dgraselli/tanteador-universal/pruebas.py

# pruebas.py
# Página web de pruebas del tablero, pensada para el celular: conectado a la
# red TNT, abrís http://192.168.216.1 y tenés un botón por prueba, para
# disparo con una mano mientras mirás el monitor con la otra.
#
# Cada prueba aísla un sospechoso del parpadeo del monitor:
#   - Silencio: abre el stream de audio HDMI sin sonido. Si el monitor
#     parpadea con esto, el enlace HDMI se cae solo por arrancar el audio.
#   - Beep: el mismo beep de un punto, pero sin tocar el tanteador.
#   - Chicharra: pulso en el GPIO, sin audio. Prueba el ruido eléctrico
#     del módulo MOSFET/relé por separado.

import fcntl
import io
import json
import math
import os
import struct
import subprocess
import sys
import threading
import time
import wave
from http.server import BaseHTTPRequestHandler, ThreadingHTTPServer

import historial
from registro import Registro, ruta_registro, ultimo_ts

PORT = int(sys.argv[1]) if len(sys.argv) > 1 else 80

REGISTRO = Registro('pruebas')

# Mismo pin y misma síntesis que tanteador.py (duplicado a propósito: importar
# tanteador acá cargaría PyQt entero en un segundo proceso, y la Zero no sobra
# memoria).
CHICHARRA_GPIO = 18
SAMPLE_RATE = 44100

def _wav_beep(pulsos, freq):
    """WAV mono de 16 bits con los pulsos (duración, silencio) en segundos.
    Con freq=0 el seno es siempre cero: sale un WAV de silencio, que igual
    abre el stream de audio HDMI, que es lo que la prueba necesita."""
    frames = bytearray()
    rampa = int(SAMPLE_RATE * 0.005)
    for dur, silencio in pulsos:
        n = int(SAMPLE_RATE * dur)
        for i in range(n):
            amp = 32000
            if i < rampa:
                amp = amp * i // rampa
            elif i > n - rampa:
                amp = amp * (n - i) // rampa
            frames += struct.pack('<h', int(amp * math.sin(2 * math.pi * freq * i / SAMPLE_RATE)))
        frames += b'\x00\x00' * int(SAMPLE_RATE * silencio)
    buf = io.BytesIO()
    with wave.open(buf, 'wb') as w:
        w.setnchannels(1)
        w.setsampwidth(2)
        w.setframerate(SAMPLE_RATE)
        w.writeframes(bytes(frames))
    return buf.getvalue()

WAVS = {
    'silencio': _wav_beep([(1.0, 0)], 0),
    'beep': _wav_beep([(0.30, 0)], 1000),   # igual al beep de anotar
}

# Una prueba a la vez: un doble toque en el celular no encima dos aplay.
_lock = threading.Lock()

def _aplay(nombre):
    # Con el daemon de audio corriendo (silencio.service), el sonido sale por
    # su FIFO: el canal HDMI ya está abierto y además el dispositivo es suyo
    # (un aplay directo daría "device busy").
    try:
        fd = os.open('/run/tnt/beeps', os.O_WRONLY | os.O_NONBLOCK)
        try:
            os.write(fd, f'{nombre}\n'.encode())
        finally:
            os.close(fd)
        return 'enviado al daemon de audio (canal HDMI siempre abierto)'
    except OSError:
        pass  # el daemon no está: aplay directo
    p = subprocess.run(['aplay', '-q'], input=WAVS[nombre],
                       stdout=subprocess.DEVNULL, stderr=subprocess.PIPE,
                       timeout=10)
    if p.returncode != 0:
        err = p.stderr.decode(errors='replace').strip()
        # 524 (ENOTSUPP): el driver vc4-hdmi no ofrece audio porque el monitor
        # no declaró soportarlo. Con un EDID que llega corrupto, pasa aunque el
        # monitor sí tenga audio: es un síntoma más del enlace HDMI fallado.
        if 'error 524' in err:
            raise RuntimeError('el HDMI quedó SIN AUDIO en este arranque: el '
                               'driver no le leyó soporte de audio al monitor '
                               '(EDID corrupto). Los beeps del tanteador '
                               'tampoco están sonando. Dato importante: '
                               'anotalo junto con la hora.')
        raise RuntimeError(err or 'aplay falló')
    return 'sonó por el parlante (HDMI)'

def _chicharra():
    import time
    import RPi.GPIO as GPIO
    GPIO.setmode(GPIO.BCM)
    GPIO.setwarnings(False)
    GPIO.setup(CHICHARRA_GPIO, GPIO.OUT, initial=GPIO.LOW)
    GPIO.output(CHICHARRA_GPIO, GPIO.HIGH)
    time.sleep(0.3)
    GPIO.output(CHICHARRA_GPIO, GPIO.LOW)
    # Sin GPIO.cleanup(): dejaría el pin como entrada y el tanteador, que ya
    # lo configuró como salida en su propio proceso, escribiría al vacío.
    return f'pulso de 0.3 s en GPIO{CHICHARRA_GPIO}'

PRUEBAS = {
    '/silencio': lambda: _aplay('silencio'),
    '/beep': lambda: _aplay('beep'),
    '/chicharra': _chicharra,
}

# ── Señal del control remoto ─────────────────────────────────────────────
# La versión para celular de medir-senal.sh: el control publica su RSSI por
# MQTT cada 5 segundos, y acá se muestra en vivo mientras caminás la cancha.
# Los puntos de medición se marcan con un botón de la página, no con el botón
# del LOCAL: así medir no suma tantos en el tablero.

UMBRALES = [(-60, 'excelente'), (-70, 'bien'),
            (-80, 'MARGINAL: se corta a ratos'), (-999, 'SIN ENLACE ÚTIL')]

def _calidad(dbm):
    for limite, texto in UMBRALES:
        if dbm >= limite:
            return texto

class Senal:
    """Escucha los 'rssi' del control por MQTT y lleva los tramos medidos."""

    def __init__(self):
        self.lock = threading.Lock()
        # (monotonic, dbm) de la última muestra. Monotonic y no time.time():
        # la hora de pared salta cuando un celular pone la Pi en hora.
        self.ultimo = None
        self.minuto = []        # muestras desde la última anotación de salud
        self.tramos = []        # una lista de dbm por cada punto marcado
        self.error = None
        try:
            import paho.mqtt.client as mqtt
            cliente = mqtt.Client()
            cliente.on_connect = lambda c, u, f, rc: c.subscribe('rssi')
            cliente.on_message = self._mensaje
            # connect_async + loop_start: reintenta solo si mosquitto no está.
            cliente.connect_async('localhost', 1883, 60)
            cliente.loop_start()
        except Exception as e:
            self.error = f'sin MQTT: {e}'

    def _mensaje(self, cliente, userdata, msg):
        try:
            dbm = int(msg.payload)
        except ValueError:
            return
        with self.lock:
            self.ultimo = (time.monotonic(), dbm)
            self.minuto.append(dbm)
            # Con 500 muestras (~40 min) alcanza para cualquier medición; el
            # tope evita crecer para siempre si alguien deja un punto abierto.
            if self.tramos and len(self.tramos[-1]) < 500:
                self.tramos[-1].append(dbm)

    def tomar_minuto(self):
        """Las muestras juntadas desde la última llamada (y las descarta)."""
        with self.lock:
            muestras, self.minuto = self.minuto, []
            return muestras

    def punto(self):
        with self.lock:
            self.tramos.append([])
            return f'punto {len(self.tramos)} marcado: quedate quieto ~20 s'

    def reset(self):
        with self.lock:
            self.tramos = []
            return 'medición reiniciada'

    def estado(self):
        with self.lock:
            r = {'error': self.error, 'ahora': None, 'tramos': []}
            if self.ultimo:
                ts, dbm = self.ultimo
                r['ahora'] = {'dbm': dbm, 'edad': round(time.monotonic() - ts),
                              'calidad': _calidad(dbm)}
            for t in self.tramos:
                if t:
                    peor = min(t)
                    r['tramos'].append({'muestras': len(t), 'peor': peor,
                                        'mejor': max(t),
                                        'media': round(sum(t) / len(t)),
                                        'calidad': _calidad(peor)})
                else:
                    r['tramos'].append({'muestras': 0})
            return r

SENAL = Senal()

# ── Bitácora: salud del tablero y reloj ──────────────────────────────────
# Lo que anota el tanteador (puntos, demoras, trabones) se completa acá con
# lo que él no ve: la señal del control, la memoria, la temperatura y la
# tensión de la fuente. historial.py lo junta todo en /historial.

# Sin noticias del control por más de esto, se anota un corte.
CORTE_CONTROL_SEG = 15

def _leer(ruta):
    with open(ruta) as f:
        return f.read()

def _salud():
    """Una foto de la Pi y del control, para la bitácora."""
    datos = {}
    try:
        mem = dict(l.split(':', 1) for l in _leer('/proc/meminfo').splitlines())
        datos['mem'] = int(mem['MemAvailable'].split()[0]) // 1024
    except (OSError, KeyError, ValueError):
        pass
    try:
        st = os.statvfs('/media/root-rw')  # lo escrito en la RAM del overlay
        datos['ram_rw'] = (st.f_blocks - st.f_bfree) * st.f_frsize // 1024
    except OSError:
        pass
    try:
        datos['carga'] = float(_leer('/proc/loadavg').split()[0])
        datos['temp'] = round(int(_leer('/sys/class/thermal/thermal_zone0/temp')) / 1000, 1)
    except (OSError, ValueError):
        pass
    try:
        # Bits de tensión baja y de baja de velocidad (actuales e históricos).
        salida = subprocess.run(['vcgencmd', 'get_throttled'], capture_output=True,
                                text=True, timeout=5).stdout
        datos['thr'] = int(salida.strip().split('=')[1], 16)
    except (OSError, IndexError, ValueError, subprocess.SubprocessError):
        pass
    muestras = SENAL.tomar_minuto()
    datos['rssi_n'] = len(muestras)   # deberían ser ~12 por minuto
    if muestras:
        datos['rssi_min'] = min(muestras)
    return datos

def _vigilar():
    """Anota la salud cada minuto y los cortes del control en cuanto pasan."""
    perdido_desde = None
    proxima_salud = time.monotonic() + 60
    while True:
        time.sleep(2)
        ahora = time.monotonic()
        with SENAL.lock:
            ultimo = SENAL.ultimo
        if ultimo:
            hace = ahora - ultimo[0]
            if perdido_desde is None and hace > CORTE_CONTROL_SEG:
                perdido_desde = ultimo[0]
                REGISTRO.anotar('control', estado='perdido')
            elif perdido_desde is not None and hace <= CORTE_CONTROL_SEG:
                REGISTRO.anotar('control', estado='vuelto',
                                seg=round(ultimo[0] - perdido_desde))
                perdido_desde = None
        if ahora >= proxima_salud:
            proxima_salud += 60
            REGISTRO.anotar('salud', **_salud())

# La Pi no tiene internet. La hora sale del módulo de reloj DS3231 (pila
# propia; ver setup-reloj.sh): el kernel la copia al sistema al arrancar.
# Además se corrige sola cuando un celular abre cualquiera de las páginas: el
# JS manda la hora del teléfono a /reloj, y esa hora se graba también en el
# módulo. Requiere CAP_SYS_TIME (ver pruebas.service).
_reloj = {'confirmado': False}

RTC = '/dev/rtc0'
# Antes de esto, la hora es la de fábrica del módulo (año 2000, pila agotada)
# o una hora rota: no se le cree.
HORA_MINIMA = 1767225600  # 2026-01-01

def _leer_rtc():
    """Segundos epoch del módulo de reloj, o None si no está o no es válida."""
    try:
        with open('/sys/class/rtc/rtc0/since_epoch') as f:
            epoch = int(f.read())
    except (OSError, ValueError):
        return None   # sin módulo, o el chip avisa que se detuvo
    return epoch if epoch >= HORA_MINIMA else None

def _guardar_en_rtc(epoch):
    """Graba la hora en el módulo (ioctl RTC_SET_TIME). Si falla, solo avisa:
    el reloj del sistema ya quedó bien."""
    t = time.gmtime(epoch)
    datos = struct.pack('9i', t.tm_sec, t.tm_min, t.tm_hour, t.tm_mday,
                        t.tm_mon - 1, t.tm_year - 1900, 0, 0, 0)
    try:
        fd = os.open(RTC, os.O_WRONLY)
        try:
            fcntl.ioctl(fd, 0x4024700a, datos)  # RTC_SET_TIME
        finally:
            os.close(fd)
    except OSError as e:
        print(f"No pude grabar la hora en el módulo de reloj ({e})", flush=True)

def _poner_en_hora(epoch, fuente):
    antes = time.time()
    time.clock_settime(time.CLOCK_REALTIME, epoch)
    REGISTRO.anotar('reloj', antes=round(antes, 3), despues=round(epoch, 3),
                    fuente=fuente)

def reloj_desde_celular(epoch):
    # Un teléfono con la fecha rota no puede mandar el tablero al pasado.
    if epoch < HORA_MINIMA:
        return 'hora del celular inválida'
    with SENAL.lock:
        if _reloj['confirmado'] and abs(epoch - time.time()) < 30:
            return 'ya estaba en hora'
        _poner_en_hora(epoch, 'celular')
        _guardar_en_rtc(epoch)
        _reloj['confirmado'] = True
    return 'puesta en hora'

def reloj_al_arrancar():
    """Con el módulo de reloj en hora, el kernel ya puso el sistema en hora:
    solo se anota, para que el historial tome este encendido como confiable.
    Sin módulo (o con la pila agotada), al menos que la hora no vaya para
    atrás respecto de lo último anotado: así el historial queda en orden. Es
    aproximada."""
    if _leer_rtc() is not None and time.time() >= HORA_MINIMA:
        ahora = round(time.time(), 3)
        REGISTRO.anotar('reloj', antes=ahora, despues=ahora, fuente='rtc')
        return
    ultimo = ultimo_ts()
    if ultimo and time.time() < ultimo:
        try:
            _poner_en_hora(ultimo + 60, 'registro')
        except OSError as e:
            print(f"No pude adelantar el reloj ({e})", flush=True)

HISTORIAL = historial.Historial()

PAGINA = """<!doctype html>
<html lang="es"><head>
<meta charset="utf-8">
<meta name="viewport" content="width=device-width, initial-scale=1">
<title>Pruebas del tablero</title>
<style>
  body { background: #111; color: #eee; font-family: sans-serif;
         max-width: 30em; margin: 0 auto; padding: 1em; }
  h1 { font-size: 1.3em; color: #ffbe00; }
  p { color: #aaa; line-height: 1.4; }
  button { display: block; width: 100%; padding: 1.1em; margin: 1em 0 0.2em;
           font-size: 1.2em; font-weight: bold; border: 0; border-radius: 0.6em;
           background: #ffbe00; color: #111; }
  button:disabled { background: #555; color: #999; }
  small { color: #888; display: block; line-height: 1.35; }
  #estado { margin-top: 1.2em; min-height: 2em; font-size: 1.1em; }
</style></head><body>
<h1>Pruebas del tablero</h1>
<p>Parate donde veas el monitor, tocá un botón y fijate si la pantalla
parpadea (se pone negra y vuelve).</p>

<button onclick="probar('/silencio', this)">&#128263; Silencio 1&nbsp;s</button>
<small>Abre el audio HDMI sin sonido. <b>La prueba clave:</b> si el monitor
parpadea con esto, el enlace HDMI se cae solo por arrancar el audio.</small>

<button onclick="probar('/beep', this)">&#128266; Beep de punto</button>
<small>El mismo beep de anotar, sin sumar ning&uacute;n punto.</small>

<button onclick="probar('/chicharra', this)">&#9889; Chicharra 0,3&nbsp;s</button>
<small>Pulso en el GPIO, sin audio. Prueba el ruido el&eacute;ctrico del
m&oacute;dulo de la chicharra por separado. Ojo: si la chicharra est&aacute;
conectada, suena fuerte.</small>

<div id="estado"></div>
<script>
// Cualquier visita desde el celular pone la Pi en hora (no tiene reloj).
fetch('/reloj', {method: 'POST', body: String(Date.now())}).catch(() => {});
async function probar(ruta, boton) {
  const estado = document.getElementById('estado');
  for (const b of document.querySelectorAll('button')) b.disabled = true;
  estado.textContent = '\\u23f3 Probando\\u2026 mir\\u00e1 el monitor';
  try {
    const r = await fetch(ruta, {method: 'POST'});
    const texto = await r.text();
    estado.textContent = (r.ok ? '\\u2705 ' : '\\u274c ') + texto;
  } catch (e) {
    estado.textContent = '\\u274c sin respuesta: ' + e;
  }
  for (const b of document.querySelectorAll('button')) b.disabled = false;
}
</script>
</body></html>
"""

PAGINA_SENAL = """<!doctype html>
<html lang="es"><head>
<meta charset="utf-8">
<meta name="viewport" content="width=device-width, initial-scale=1">
<title>Señal del control remoto</title>
<style>
  body { background: #111; color: #eee; font-family: sans-serif;
         max-width: 30em; margin: 0 auto; padding: 1em; }
  h1 { font-size: 1.3em; color: #ffbe00; }
  p, small { color: #aaa; line-height: 1.4; }
  #dbm { font-size: 4em; font-weight: bold; text-align: center; margin: 0.2em 0 0; }
  #calidad { text-align: center; font-size: 1.3em; min-height: 1.4em; }
  #edad { text-align: center; color: #888; min-height: 1.4em; }
  button { display: block; width: 100%; padding: 1.1em; margin: 1em 0 0.2em;
           font-size: 1.2em; font-weight: bold; border: 0; border-radius: 0.6em;
           background: #ffbe00; color: #111; }
  button.gris { background: #444; color: #ccc; }
  table { width: 100%; border-collapse: collapse; margin-top: 1em; }
  th, td { padding: 0.4em 0.3em; text-align: right; border-bottom: 1px solid #333; }
  th:first-child, td:first-child { text-align: left; }
  .exc { color: #5d5; } .bien { color: #cc5; } .marg { color: #f92; } .mal { color: #f55; }
</style></head><body>
<h1>Señal del control remoto</h1>
<p>Caminá la cancha con el control <b>encendido</b> mirando esto (publica cada
5&nbsp;s). En cada punto que quieras medir, tocá <b>Marcar punto</b> y quedate
quieto ~20&nbsp;s. No suma tantos en el tablero.</p>

<div id="dbm">—</div>
<div id="calidad"></div>
<div id="edad"></div>

<button onclick="accion('/punto')">&#128205; Marcar punto</button>
<button class="gris" onclick="accion('/senal/reset')">Reiniciar medici&oacute;n</button>

<div id="aviso"></div>
<table id="tramos" hidden>
<thead><tr><th>Punto</th><th>muestras</th><th>peor</th><th>mejor</th><th>media</th></tr></thead>
<tbody></tbody>
</table>
<small>La calidad de cada punto se juzga por el <b>peor</b> valor: de −30 a −60
excelente, hasta −70 bien, hasta −80 marginal (se corta a ratos), peor que −85
no hay enlace. El número que importa es el peor del punto más lejano.</small>

<script>
// Cualquier visita desde el celular pone la Pi en hora (no tiene reloj).
fetch('/reloj', {method: 'POST', body: String(Date.now())}).catch(() => {});
function clase(dbm) {
  return dbm >= -60 ? 'exc' : dbm >= -70 ? 'bien' : dbm >= -80 ? 'marg' : 'mal';
}
async function refrescar() {
  let e;
  try { e = await (await fetch('/senal/datos')).json(); }
  catch (err) { document.getElementById('calidad').textContent = 'sin respuesta de la Pi'; return; }
  const dbm = document.getElementById('dbm');
  const cal = document.getElementById('calidad');
  const edad = document.getElementById('edad');
  if (e.error) { cal.textContent = e.error; return; }
  if (!e.ahora) {
    dbm.textContent = '—';
    cal.textContent = 'esperando al control\\u2026';
    edad.textContent = '\\u00bfest\\u00e1 prendido y en la red?';
  } else {
    dbm.textContent = e.ahora.dbm;
    dbm.className = clase(e.ahora.dbm);
    cal.textContent = e.ahora.calidad;
    cal.className = clase(e.ahora.dbm);
    edad.textContent = e.ahora.edad > 12
      ? 'sin noticias hace ' + e.ahora.edad + ' s \\u2014 \\u00bfse apag\\u00f3 el control?'
      : 'hace ' + e.ahora.edad + ' s';
  }
  const tabla = document.getElementById('tramos');
  tabla.hidden = e.tramos.length === 0;
  const cuerpo = tabla.querySelector('tbody');
  cuerpo.innerHTML = '';
  e.tramos.forEach((t, i) => {
    const tr = document.createElement('tr');
    if (t.muestras === 0) {
      tr.innerHTML = '<td>' + (i + 1) + '</td><td>0</td><td colspan="3">esperando muestras\\u2026</td>';
    } else {
      tr.innerHTML = '<td>' + (i + 1) + '</td><td>' + t.muestras + '</td>' +
        '<td class="' + clase(t.peor) + '">' + t.peor + '</td>' +
        '<td>' + t.mejor + '</td><td>' + t.media + '</td>';
    }
    cuerpo.appendChild(tr);
  });
}
async function accion(ruta) {
  try { await fetch(ruta, {method: 'POST'}); } catch (e) {}
  refrescar();
}
refrescar();
setInterval(refrescar, 2000);
</script>
</body></html>
"""

class Handler(BaseHTTPRequestHandler):

    def _responder(self, codigo, texto, tipo='text/plain'):
        cuerpo = texto.encode()
        self.send_response(codigo)
        self.send_header('Content-Type', f'{tipo}; charset=utf-8')
        self.send_header('Content-Length', str(len(cuerpo)))
        self.end_headers()
        self.wfile.write(cuerpo)

    def do_GET(self):
        if self.path == '/':
            self._responder(200, PAGINA, 'text/html')
        elif self.path == '/senal':
            self._responder(200, PAGINA_SENAL, 'text/html')
        elif self.path == '/senal/datos':
            self._responder(200, json.dumps(SENAL.estado()), 'application/json')
        elif self.path == '/historial':
            self._responder(200, historial.PAGINA, 'text/html')
        elif self.path == '/historial/datos':
            self._responder(200, json.dumps(HISTORIAL.datos()), 'application/json')
        elif self.path == '/historial/registro.jsonl':
            try:
                with open(ruta_registro(), 'rb') as f:
                    cuerpo = f.read()
            except OSError:
                cuerpo = b''
            self.send_response(200)
            self.send_header('Content-Type', 'application/x-ndjson')
            self.send_header('Content-Disposition', 'attachment; filename="registro-tablero.jsonl"')
            self.send_header('Content-Length', str(len(cuerpo)))
            self.end_headers()
            self.wfile.write(cuerpo)
        else:
            self._responder(404, 'no existe')

    def do_POST(self):
        # Las acciones de la medición de señal no compiten por nada: van sin
        # el lock de las pruebas de sonido.
        if self.path == '/reloj':
            try:
                largo = int(self.headers.get('Content-Length', 0))
                epoch = int(self.rfile.read(largo)) / 1000
                self._responder(200, reloj_desde_celular(epoch))
            except (ValueError, OSError) as e:
                self._responder(500, f'no pude poner la hora: {e}')
            return
        if self.path == '/punto':
            self._responder(200, SENAL.punto())
            return
        if self.path == '/senal/reset':
            self._responder(200, SENAL.reset())
            return
        prueba = PRUEBAS.get(self.path)
        if prueba is None:
            self._responder(404, 'no existe')
            return
        if not _lock.acquire(blocking=False):
            self._responder(409, 'hay una prueba en curso, esperá que termine')
            return
        try:
            self._responder(200, prueba())
        except Exception as e:
            self._responder(500, f'falló: {e}')
        finally:
            _lock.release()

    def log_message(self, formato, *args):
        # Al journal, para correlacionar cada prueba con lo que se vio.
        print(f"{self.address_string()} {formato % args}", flush=True)

def main():
    reloj_al_arrancar()
    REGISTRO.anotar('inicio')
    threading.Thread(target=_vigilar, daemon=True).start()
    servidor = ThreadingHTTPServer(('', PORT), Handler)
    print(f"Página de pruebas en el puerto {PORT}", flush=True)
    servidor.serve_forever()

if __name__ == '__main__':
    main()
