dgraselli/tanteador-universal/(commit log)

2026-01-02 Add donation credits for cables and protector
    Added acknowledgment for donated cables and voltage protector.
2026-07-14 Sacar las credenciales del repo
    La contraseña del AP estaba escrita en setup-ap.sh y quedó publicada en el
    commit inicial. Ahora vive en secrets.env, que está en .gitignore; el repo
    solo lleva las plantillas .example.
    El .gitignore también deja afuera los volcados de flash del ESP (*.bin), que
    llevan la contraseña del WiFi en texto plano, y las imágenes de SD.
    En setup-ap.sh, además:
    - El SSID deja de estar oculto. Esconderlo no aporta seguridad (la red aparece
    igual en un escaneo pasivo apenas un cliente se asocia) y obliga al ESP8266 a
    asociarse por probe requests dirigidas, que es lento y falla seguido.
    - El canal pasa a ser una variable. Solo 1, 6 y 11 no se solapan entre s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
2026-07-14 Firmware: arreglar los botones, sacar el modem sleep y agregar OTA
    Tres bugs reales en la máquina de estados de los botones, verificados con una
    simulación de la lógica en C (millis/digitalRead/publish falsos):
    - Mantener apretado un botón emitía una resta por cada vuelta del loop pasado
    el segundo: 3s de pulsación = 2 restas, 5s = 4. La bandera de pulsación larga
    se seteaba pero no se consultaba. Es justo lo que hace un jugador cuando cree
    que el botón no anduvo y aprieta más fuerte.
    - El combo de cambio de tema (los dos botones juntos) disparaba un punto
    espurio antes del theme, y otro al soltar los botones de a uno.
    - Un rebote de contacto de 10ms emitía un punto fantas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
    [tanteador_remoto_LOLIN.ino]
2026-07-14 Tanteador: indicador del último punto y arreglo del cruce de hilos
    Visual:
    - El borde del equipo que hizo el último punto es más grueso (3.5% del alto).
    - Debajo de su panel aparece un triángulo hacia arriba del mismo color, pegado
    al borde exterior para no pisar el reloj, que está centrado.
    - 50px de margen contra el borde superior de la pantalla.
    Los mensajes MQTT llegaban en el hilo de red de paho y tocaban self.scores
    mientras paintEvent lo leía desde el hilo gráfico. Ahora los cruza una
    pyqtSignal, que es la única forma soportada de hablarle a un widget desde otro
    hilo.
    Además: el sonido se lanza después de repintar (arrancar aplay cuesta ~1ms y el
    jugador no tiene por qu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
    [tanteador.py]
2026-07-14 Herramientas para actualizar el tanteador en el club
    Hasta ahora el tanteador lo lanzaba el .xinitrc, así que para reiniciarlo había
    que reiniciar la Pi, y si se caía en pleno partido no volvía.
    - tanteador.service: lo maneja systemd, se reinicia solo si se cae y arranca sin
    límite de reintentos (durante el boot falla a propósito varias veces, hasta que
    X existe).
    - deploy.sh: empuja el código desde la notebook y reinicia el servicio. La Pi no
    tiene internet (su única radio es el AP), así que no puede hacer git pull.
    Sincroniza también el unit file: la Pi tenía uno viejo apuntando a un archivo
    que ya no existe, y un deploy que solo pregunta si el servicio existe lo
    re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
    [costos.ods]
2026-07-14 Medir la señal del control remoto a lo largo de la cancha
    El firmware publica el RSSI cada 5 segundos, y los botones también publican: eso
    alcanza para medir sin herramientas extra. Cada pulsación del botón del local
    marca un punto de medición, y el script resume el peor, el mejor y la media de
    cada tramo.
    La medición termina por tiempo y no por Ctrl-C. Es a propósito: bash le pone
    SIGINT en "ignorar" a los procesos lanzados con & desde un script no interactivo,
    así que un Ctrl-C dejaba el ssh colgado y el resumen no salía nunca. Con el ssh
    dentro de la tubería y un timeout, el resumen sale siempre.
    Claude-Session: https://c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
2026-07-14 Diagrama de orientación de las antenas
    Las dos placas tienen antena impresa en el PCB, así que "orientar la antena"
    es orientar la placa. Con las dos verticales, los puntos ciegos de la rosquilla
    de radiación apuntan al piso y al techo, y ambas quedan con la misma
    polarización: cruzarlas cuesta entre 10 y 20 dB, más que cualquier otra cosa
    que se pueda hacer.
    Claude-Session: https://claude.ai/code/session_01AWrU6h4YDgRoqFzGjpHaqT
2026-07-14 Cartel de arranque: CLUB UNIVERSAL en lugar del log del kernel
    La Pi mostraba el log de arranque hasta que levantaba X. Ahora muestra un cartel
    grande, parametrizable en splash.conf: el texto y un color por palabra.
    TEXTO="CLUB UNIVERSAL"
    COLORES="rojo verde"
    splash.py trae la fuente adentro y no depende de nada: la Pi no tiene internet,
    así que no se le puede instalar figlet ni plymouth. Los bloques son de 7x7 con
    trazos de 2 píxeles, como el ANSI Shadow de show_universal.sh; con trazos de 1
    píxel las letras se ven flacas en una pantalla de 1920x1080. El reparto en
    renglones y la escala se calculan solos para llenar la consola (240x67).
    setup-splash.sh agrega quiet, loglevel=3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
2026-07-14 deploy: grabar en la SD también los symlinks que habilitan los servicios
    El splash.service quedaba deshabilitado en cada reboot. 'systemctl enable' crea
    un symlink en <target>.wants/, y ese symlink vivía en la capa RAM del overlay:
    el reinicio se lo llevaba. El tanteador.service no lo sufría solo porque su
    symlink ya estaba grabado en la SD desde antes de que se activara el readonly.
    Ahora deploy.sh graba el unit y su symlink, así que cualquier servicio nuevo
    persiste solo. De paso, las listas de archivos y de units se declaran arriba en
    vez de repetir el bloque para cada uno.
    Claude-Session: https://claude.ai/code/session_01AWrU6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
2026-07-14 Cartel de arranque grande: llena el 90% del ancho
    La fuente ANSI Shadow, con la sombra 3D, se veía chica: al ser de dibujo de caja
    no se puede agrandar sin que se rompa. Se cambió por ANSI Regular (bloque macizo,
    solo █), que sí escala.
    splash.py guarda cada letra como un bitmap de puntos; dos filas de puntos entran
    en una fila de consola con medios bloques (▀ ▄ █), lo que duplica la resolución
    vertical y deja escalar sin romper nada. Elige sola la escala más grande que
    llene ~90% del ancho y entre en la pantalla: con "CLUB UNIVERSAL" queda en x3,
    88% del ancho. Se pierde el relieve 3D, pero se gana el tamaño.
    Claude-Sess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
2026-07-14 Anti doble-punto: un tanto por equipo cada 1.5s
    A veces el doble apretón del botón (o un rebote del pulsador) anotaba dos tantos.
    Ahora el marcador ignora una segunda suma del mismo equipo si llega dentro de
    COOLDOWN_PUNTO segundos. Se hace acá y no en el ESP porque se ajusta y despliega
    sin reflashear, y porque el marcador distingue suma de resta: las restas nunca
    se limitan, para que una corrección entre siempre.
    En pelota no hay dos tantos tan seguidos, así que el límite no bloquea juego
    legítimo. El valor es una constante arriba del archivo, fácil de subir a 2.
    Claude-Session: https://claude.ai/code/session_01AWrU6h4YDgRoq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
2026-07-15 Beeps sintetizados, temas nuevos y cooldown también al restar
    - Los sonidos wav desaparecen: los beeps se generan en memoria y van a
    aplay por stdin (anotar: 1 beep fuerte igual para ambos; restar: 2
    cortitos; reset: 1 grave).
    - Temas: local en bermellón (nuevo tema inicial) y ámbar sobre fondo
    negro; los claros quedan al final de la rotación.
    - El cooldown anti doble-punto (0.5s) también filtra las restas, con
    registro separado para que una corrección entre siempre.
    - Tanteos anchos (18, 29) ya no se cortan: la fuente se achica sola
    cuando el número no entra en el panel.
    - El panel del último que anotó ya no lleva borde: queda solo la flecha.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
    [tanteador.py]
2026-07-15 Chicharra de 12V por GPIO18, sonando junto al parlante
    Los beeps salen por el pin (vía MOSFET/relé) y por aplay a la vez, con el
    mismo ritmo: el pin queda activo aunque no haya nada conectado, así que
    enchufar la chicharra no requiere tocar código. Si RPi.GPIO falta o el
    pin no se puede tomar, cae solo al parlante. Conexionado en el README.
2026-07-15 Script de backup de la SD por ssh, sin sacarla del tablero
    Aprovecha que la Pi corre en solo lectura: la SD no cambia durante la
    copia y la imagen queda consistente (se niega si quedó montada rw).
    Comprime en la Pi con gzip -1, verifica el archivo al final y descarta
    copias incompletas.
2026-07-16 Página de pruebas del monitor para el celular
    En http://192.168.216.1 (red TNT), un botón por prueba para diagnosticar
    el parpadeo del monitor sin llevar la notebook al club: abrir el audio
    HDMI en silencio (la prueba clave del enlace), sonar el beep de un punto
    sin sumar nada, y pulsar la chicharra por GPIO sin audio. La sirve
    pruebas.py como servicio systemd, en el puerto 80 sin ser root
    (CAP_NET_BIND_SERVICE), y viaja con deploy.sh como todo lo demás.
2026-07-16 La prueba de audio explica el error 524 (HDMI sin audio)
    Cuando el driver vc4-hdmi no le leyó soporte de audio al monitor (pasa
    con el EDID corrupto), aplay muere con ENOTSUPP y el "Unknown error 524"
    no le dice nada a nadie. La página ahora lo traduce: no hay audio HDMI
    en este arranque, los beeps del tanteador tampoco suenan, anotá la hora.
    [pruebas.py]
2026-07-16 Señal del control remoto en vivo, en /senal, para el celular
    La versión para celular de medir-senal.sh: la Pi escucha los rssi del
    control por MQTT y los muestra en vivo en http://192.168.216.1/senal,
    con el dBm grande y coloreado por calidad. Los puntos de medición se
    marcan con un botón de la página en vez del botón del LOCAL, así medir
    no suma tantos en el tablero; el resumen (peor/mejor/media por punto,
    calidad según el peor) se va armando en pantalla. La página del monitor
    queda como estaba, en /.
2026-07-16 Colchón de silencio antes de cada beep: el HDMI se los comía
    El monitor tarda unas décimas en abrir el audio cuando arranca el stream
    HDMI, y los beeps cortos (sumar 0.3s, restar 0.08+0.08) terminaban antes
    de escucharse; el de reset (0.5s) llegaba de casualidad. Ahora cada wav
    arranca con 0.4s de silencio para que el tono encuentre el canal abierto.
    La chicharra por GPIO no lo necesita y sigue sonando al instante.
    [pruebas.py, tanteador.py]
2026-07-16 Daemon de audio: el canal HDMI queda siempre abierto
    El monitor abre el audio con retardo y fade-in cada vez que un aplay
    arranca: los beeps cortos salían cortados o bajitos, y el colchón de
    silencio del commit anterior los atrasaba medio segundo. dmix no es una
    opción acá (el vc4-hdmi solo acepta IEC958), así que silencio.py es un
    único proceso dueño del dispositivo: reproduce silencio todo el tiempo
    y recibe los beeps por un FIFO (/run/tnt/beeps), intercalándolos sin
    cerrar nunca el canal. Escrituras marcadas por reloj y buffer de 100 ms
    para que el beep no espere atrás de silencio ya encolado.
    tanteador.py y pruebas.py escriben al FIFO y, si el daemon no está,
    caen solos al apl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
2026-07-16 Vigía del fullscreen: el tablero arrancaba en negro
    Al encender el tablero, X levanta antes de que el monitor termine de
    negociar el EDID: el showFullScreen del arranque se hace contra una
    pantalla que todavía no existe y la ventana queda de 1x1, invisible
    hasta que alguien reinicia el servicio. Un timer compara cada 5 s la
    geometría de la ventana con la de la pantalla y la reestira en cuanto
    la pantalla real aparece. También cubre enchufar o cambiar el monitor
    con el tanteador ya corriendo.
2026-10-02 Bitácora en pendrive, historial web, control cableado y sonido apagado
    En la cancha el tablero se volvió lento y en casa no se reproduce: hacía
    falta registrar lo que pasa allá. La SD está en solo lectura, así que la
    bitácora va a un pendrive aparte (etiqueta TNTLOG, media-tntlog.mount).
    - registro.py: una línea JSON por evento, escrita desde un hilo propio
    para que un USB lento no frene la pantalla. Cada evento lleva el id
    del encendido y los segundos desde el arranque, porque la Pi no tiene
    reloj: cuando un celular abre cualquier página la pone en hora
    (CAP_SYS_TIME) y el historial corrige todo ese encendido.
    - tanteador.py anota cada punto con cuánto esperó y cuánto t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
    [botones.py, historial.py, pruebas.py, registro.py, tanteador.py]
2026-10-05 Toques confirmados, buzzer en los controles y resolución fija
    La bitácora de la cancha (2 al 5 de octubre) mostró tres cosas: el
    primer 10 de cada encendido tardaba hasta un segundo en aparecer; con
    la señal floja (-80 dBm) los toques del control wifi quedaban trabados
    en TCP y caían de golpe segundos después, y quien apretaba no tenía
    cómo saber si el punto había entrado; y la resolución cambiaba de un
    arranque a otro (1024x768, 1600x900, 1920x1080) porque el EDID llega
    roto por el cable.
    - tanteador.py: _encoger_hasta_entrar salta directo al tamaño de fuente
    que entra, en vez de bajar de a 2 puntos: el primer número de dos
    cifras cargaba ~45 tamaños nuevos (95 ms -> 7 ms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
    [historial.py, tanteador.py, tanteador_remoto_LOLIN.ino]
2026-10-06 Control: el nonce se genera después de conectar el WiFi
    El generador de números al azar del ESP8266 saca el azar del ruido de la
    radio: antes de encenderla, el valor es menos aleatorio y dos arranques
    podían repetir nonce. Probado en el control: conecta, manda el latido y
    los toques entran con 0 a 11 ms de atraso, confirmados al primer envío.
2026-10-06 Control: buzzer en S3 (GPIO10) y la placa es una NodeMCU v3 LOLIN
    El control no es un Wemos D1 Mini sino una NodeMCU v3 LOLIN (CH340):
    corregidas las menciones en README, ACTUALIZAR (en el Arduino IDE, placa
    "NodeMCU 1.0" con Flash Mode DIO), el firmware y los scripts. Los nombres
    D1..D8 apuntan a los mismos GPIO en las dos placas, así que los botones y
    el LED no cambian.
    El buzzer pasa al lado izquierdo, junto a VIN y G que lo alimentan: S3
    (GPIO10), el único pin de ese lado que se puede usar. Es de la flash y
    queda libre solo con el firmware en modo DIO; en QIO tocarlo cuelga el
    ESP. setup() mira el modo real y, si no es DIO/DOUT, deja el buzzer
    apagado en vez de colgarse. Probado en el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
    [tanteador_remoto_LOLIN.ino]
2026-10-07 Diagramas de instalación: antenas en esta cancha y control cableado
    orientacion-antenas.svg: panel nuevo con la instalación real (la Pi
    empotrada detrás del monitor, el control detrás de la reja) y cómo
    sacarles la sombra: antena del dongle USB afuera de la tapa, caja
    separada de la reja y con la antena por encima del borde. Wemos ->
    NodeMCU v3 LOLIN, Pi Zero W -> Pi Zero 2 W, y la meta de -70 dBm en
    /senal.
    instalacion-cableada.svg: el recorrido del UTP (alto, fijado, fuera de
    la zona de juego, entrada por abajo con panza), los dos errores típicos
    (agua por el cable, paralelo a 220 V) y qué va en cada punta.
2026-10-07 Reloj con pila DS3231: la Pi sabe la hora sin que nadie se conecte
    Sin reloj propio ni internet, cada encendido arrancaba con una hora vieja
    hasta que un celular abría una página. Un módulo DS3231 en I2C (pines
    17, 20, 3 y 5) guarda la hora con su pila; al arrancar, el kernel la
    copia al sistema solo.
    - setup-reloj.sh (una vez): activa I2C y el overlay i2c-rtc,ds3231 en
    config.txt (copia en config.txt.antes-del-reloj), una regla de udev
    para que pruebas.py grabe en /dev/rtc0, y la zona horaria de Argentina
    para que date y journalctl no salgan en hora de Londres. --revertir.
    - pruebas.py: al arrancar, si el módulo tiene una hora válida (2026 en
    adelante) la anota como 'reloj' co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
    [historial.py, pruebas.py]
2026-10-07 Control: buzzer pasivo en D6, afinado a su resonancia (1800 Hz)
    S3 (GPIO10) no sirve en este control: es la pata WP de la memoria flash
    y, aunque en modo DIO se puede mover sin nada conectado, apenas se le
    conecta el buzzer el ESP se cuelga (probado: sin el cable de señal
    anda, con el cable se cuelga). El buzzer pasa a D6 (GPIO12); el módulo
    puede quedar montado del lado izquierdo, alimentado por G y 3V, con
    solo la señal cruzando a D6. Queda la advertencia en el firmware, el
    README y ACTUALIZAR.
    El buzzer del control es pasivo (KY-006, patas -, + y S): manejado como
    activo solo hacía "tic", así que BUZZER_ACTIVO = false. Probando tonos
    de 1400 a 4000 Hz, el que más suena es 1800 Hz: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
    [tanteador_remoto_LOLIN.ino]
